nekrasov-d/gabella/pcb/gabella_main.pdf

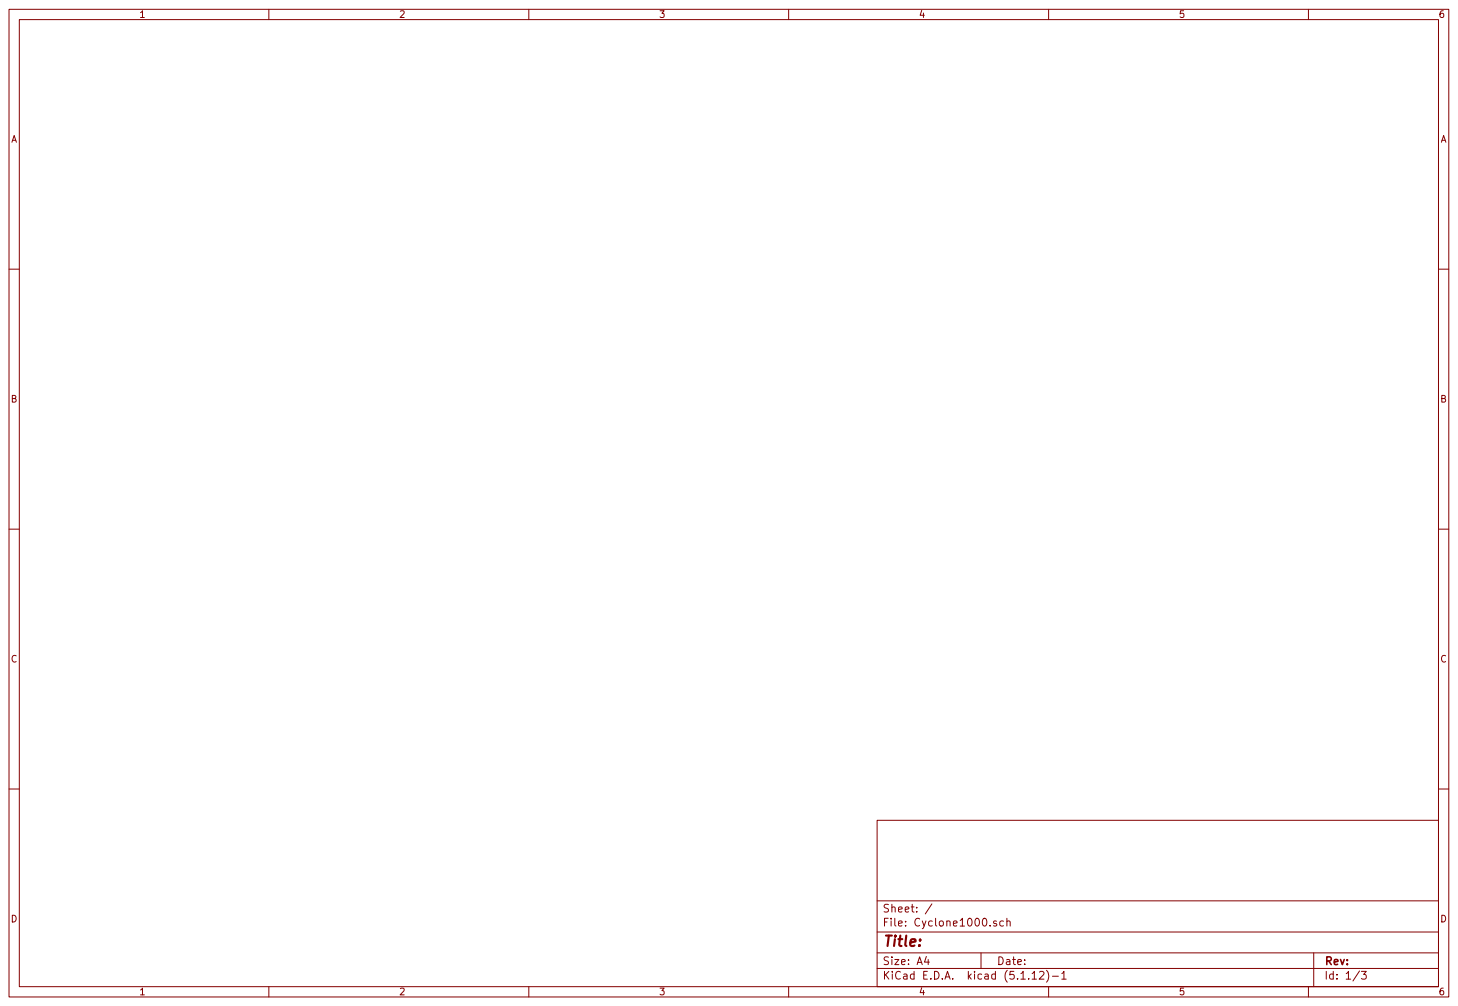
[picture p2: page 1]

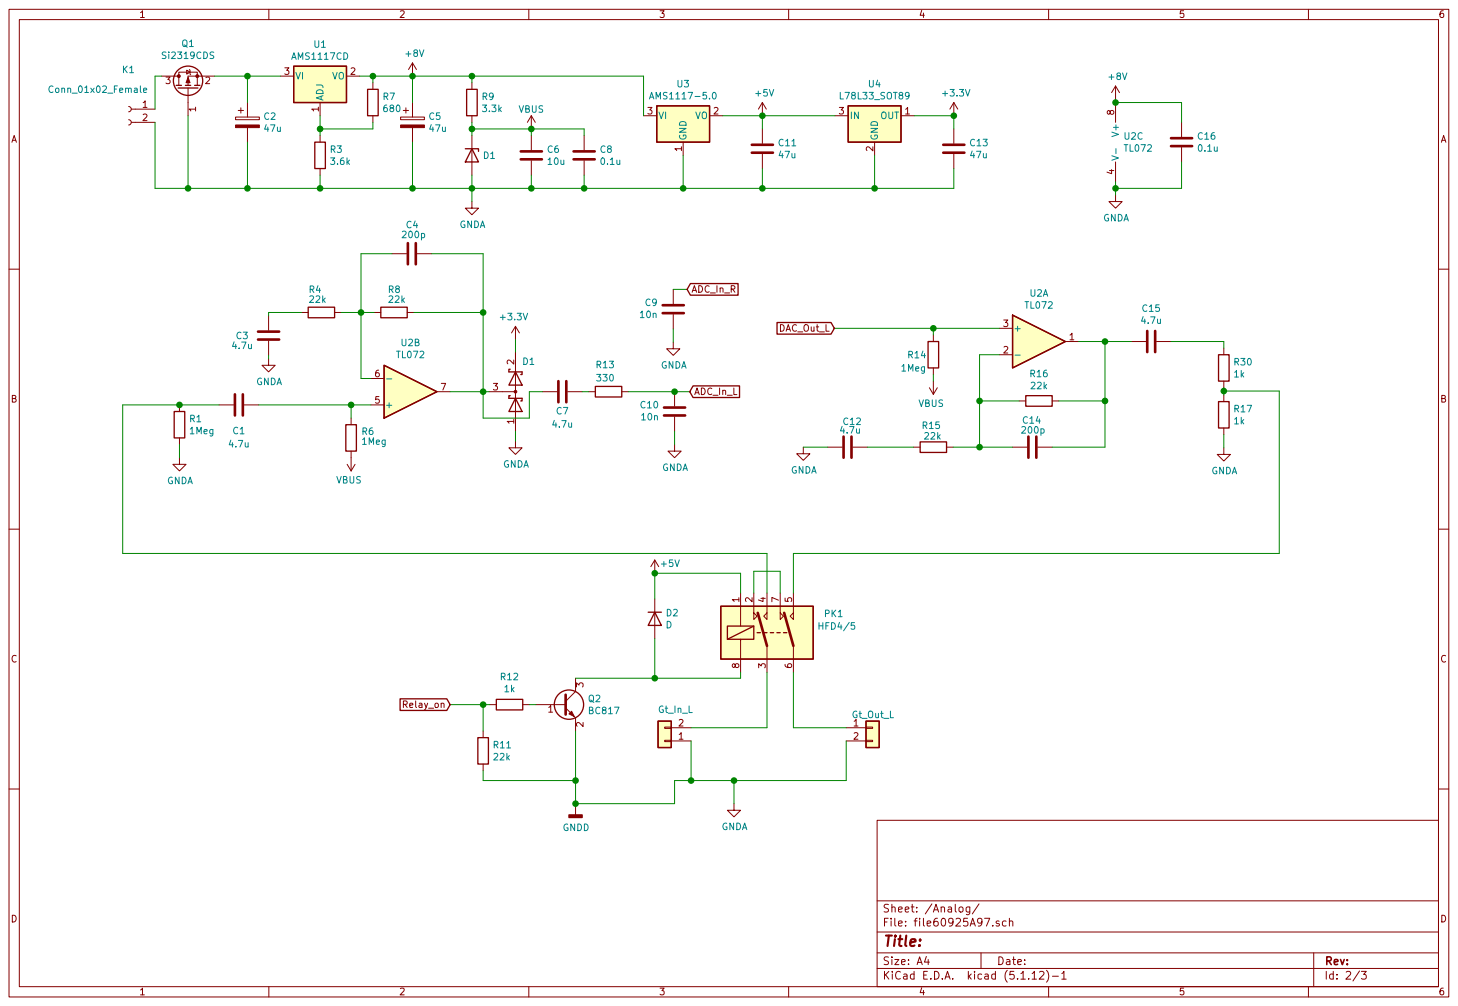
[picture p3: page 2]

Id: 2/3 Title: File: file60925A97.sch Sheet: /Analog/

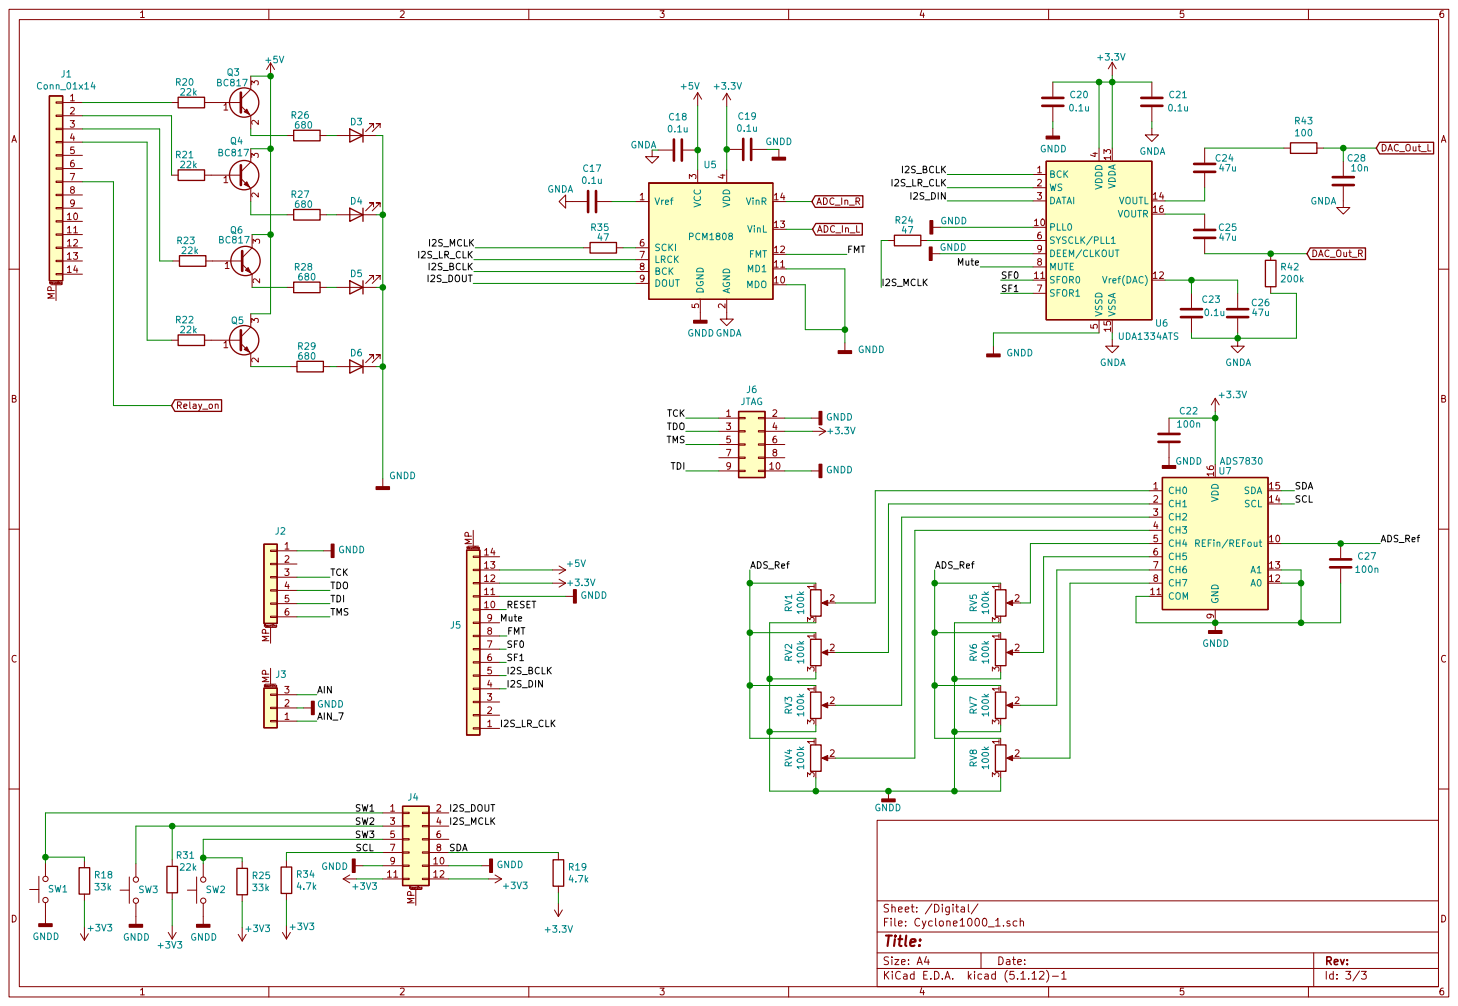
[picture p4: page 3]

5 SYSCLK/PLL1 6 SFOR1 7 MUTE 8 DEEM/CLKOUT 9 U6 UDA1334ATS
