nekrasov-d/gabella/(commit log)

2022-07-10 Add .gitignore, fix low pass filter
2023-04-16 Add fir filter as an external repo
2023-04-16 Switch to WTFPL
2024-04-07 Remove outdated fir_filter submodule, it is going to be replaced with digital-filters
2024-04-07 add digital-filters submodule
2024-04-08 Switch to MIT license
2024-04-11 Use 'gabella' branch in digital-filters submodule, tuned to this project
2024-08-09 Update digital-fiter (again, I forgot to add boxcar filter there)s submodule
2024-08-09 Replace native 'primitive_lowpass_filter' with the same 'boxcar_filter' from filters submodule
    [delay_reflections_pipeline.sv]
2024-08-21 Redo treomolo, switch to the runtime divider instead of probability ROM, new features, etc
2024-09-29 add pcb, update README.md
